HusseinElsherbini/Self_Balancing_Robot/Images/SBR_IMU_SCHEM.JPG

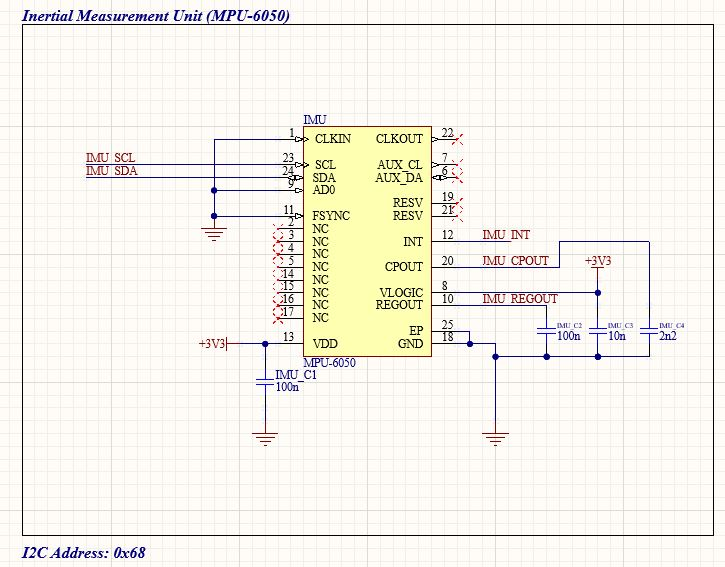
Images/SBR_IMU_SCHEM.JPG
