HusseinElsherbini/Self_Balancing_Robot/Images/SBR_MCU_SCHEM.JPG

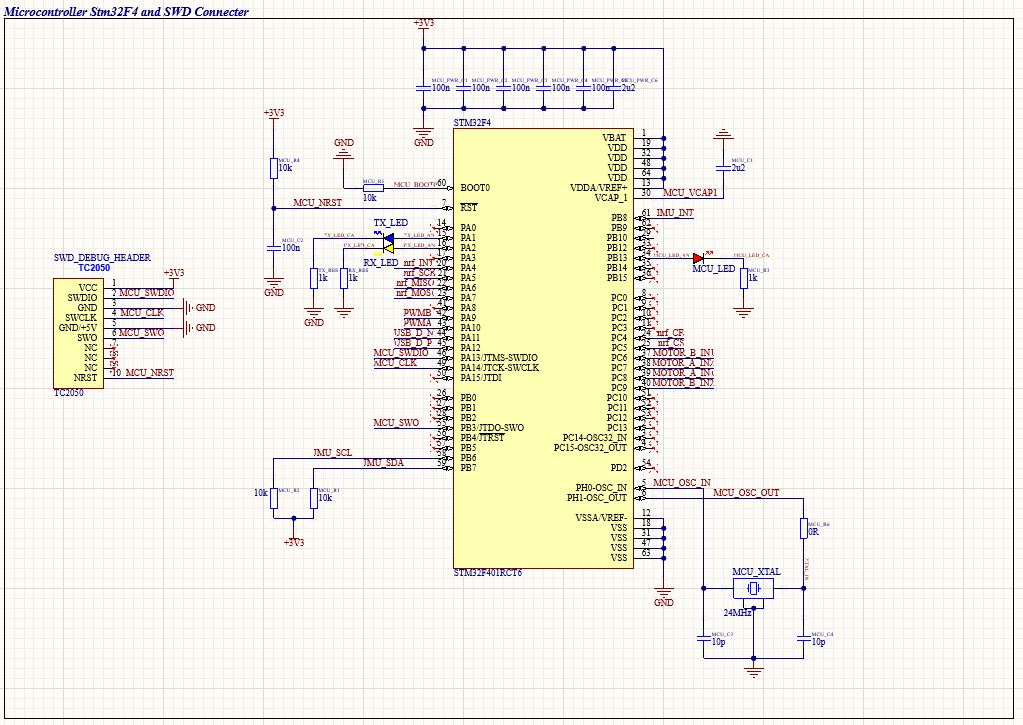
Images/SBR_MCU_SCHEM.JPG
