HusseinElsherbini/Self_Balancing_Robot/Images/SBR_SCHEM.JPG

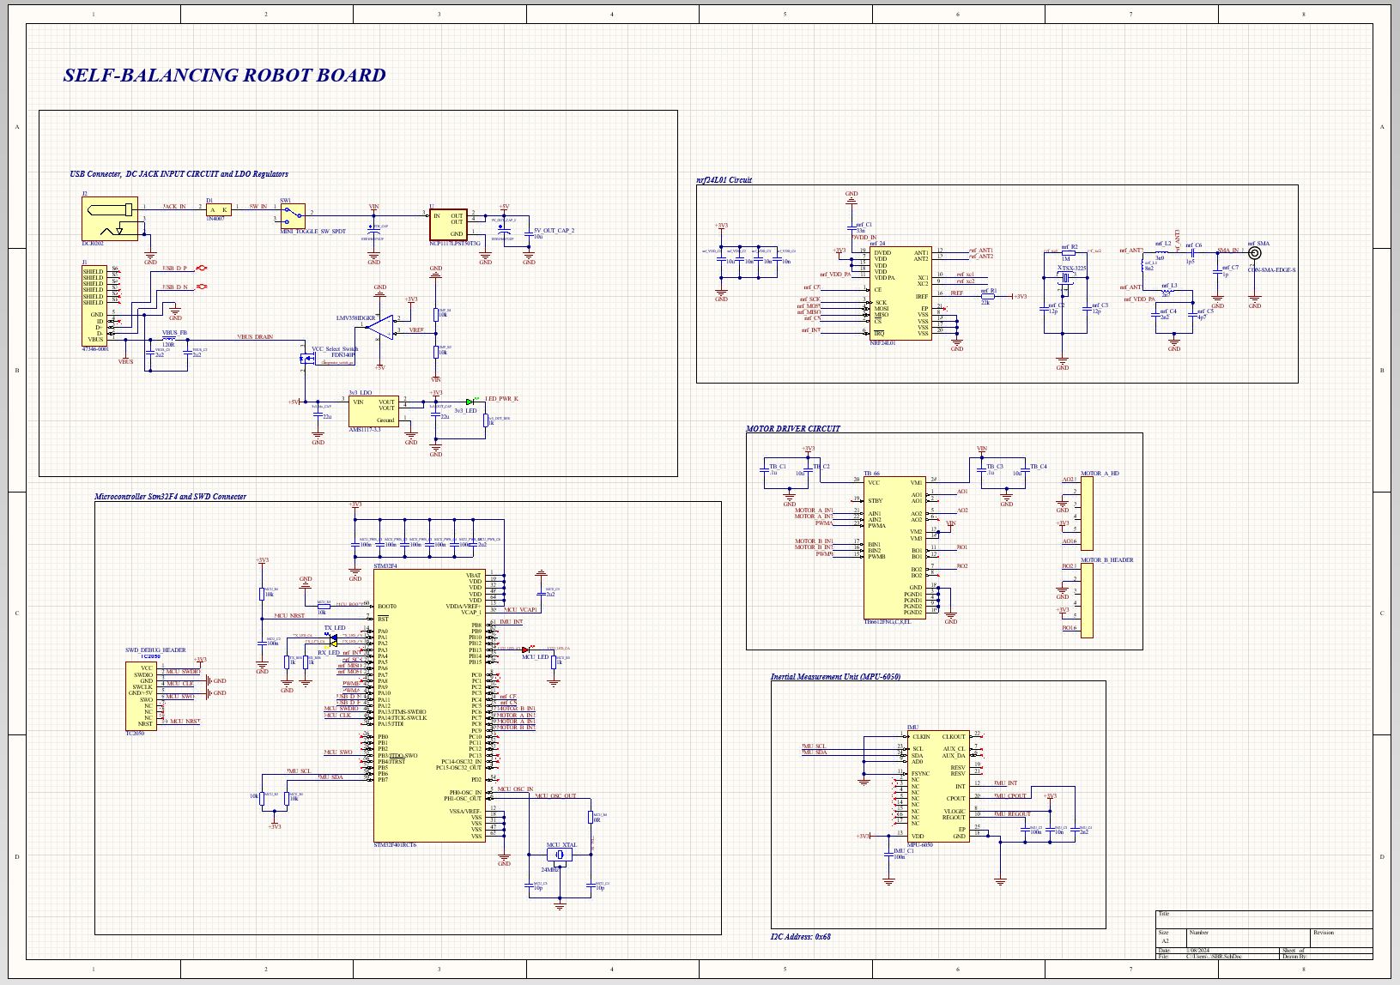
Images/SBR_SCHEM.JPG
