HusseinElsherbini/Self_Balancing_Robot/Images/SBR_TB66_SCHEM.JPG

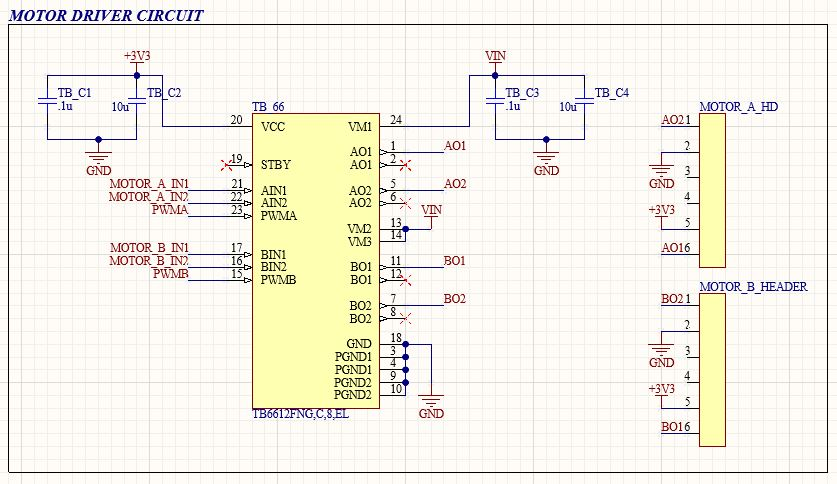
Images/SBR_TB66_SCHEM.JPG
