HusseinElsherbini/Self_Balancing_Robot/inc/timer_common.h

#ifndef TIMER_COMMON_H_
#define TIMER_COMMON_H_

#include "stdint.h"
#include "platform.h"

#define TIM_CR1_CKD_CK_INT      (0x0 << 8U)
#define TIM_CR1_CMS_EDGE        (0x0 << 5U)
#define TIM1_CR1_DIR_UP         (0x0 << 4U)
#define TIM1_CR1_DIR_DOWN       (0x1 << 4U)

#define RCC_APB1ENR_TIM2EN_Pos             (0U)                                
#define RCC_APB1ENR_TIM2EN_Msk             (0x1UL << RCC_APB1ENR_TIM2EN_Pos)    /*!< 0x00000001 */
#define RCC_APB1ENR_TIM2EN                 RCC_APB1ENR_TIM2EN_Msk          /*!< TIM2 clock enable */

#define RCC_APB1ENR_TIM3EN_Pos             (1U)
#define RCC_APB1ENR_TIM3EN_Msk             (0x1UL << RCC_APB1ENR_TIM3EN_Pos)    /*!< 0x00000002 */
#define RCC_APB1ENR_TIM3EN                 RCC_APB1ENR_TIM3EN_Msk          /*!< TIM3 clock enable */

#define RCC_APB1ENR_TIM4EN_Pos             (2U)
#define RCC_APB1ENR_TIM4EN_Msk             (0x1UL << RCC_APB1ENR_TIM4EN_Pos)    /*!< 0x00000004 */      
#define RCC_APB1ENR_TIM4EN                 RCC_APB1ENR_TIM4EN_Msk          /*!< TIM4 clock enable */

typedef struct 
{
    volatile uint32_t CR1;           
    volatile uint32_t CR2;       
    volatile uint32_t SMCR;       
    volatile uint32_t DIER;        
    volatile uint32_t SR;             
    volatile uint32_t EGR;            
    volatile uint32_t CCMR1;          
    volatile uint32_t CCMR2;            
    volatile uint32_t CCER;          
    volatile uint32_t CNT;     
    volatile uint32_t PSC;          
    volatile uint32_t ARR;     
    volatile uint32_t RCR;          
    volatile uint32_t CCR1;  
    volatile uint32_t CCR2;          
    volatile uint32_t CCR3; 
    volatile uint32_t CCR4;  
    volatile uint32_t BDTR;          
    volatile uint32_t DCR; 
    volatile uint32_t DMAR;  

}TIM_REGS_T;

#define TIM1                ((TIM_REGS_T *) TIM1_BASE)   
#define TIM2                ((TIM_REGS_T *) TIM2_BASE)
#define TIM3                ((TIM_REGS_T *) TIM3_BASE)
#define TIM4                ((TIM_REGS_T *) TIM4_BASE)
#define TIM5                ((TIM_REGS_T *) TIM5_BASE) 
#define TIM10               ((TIM_REGS_T *) TIM10_BASE)

#define CH1                1U
#define CH2                2U
#define CH3                3U
#define CH4                4U

#define CCRx_CHANNEL_PERIPH_OFFSET(CHANNEL)      (0x30 + 4U*CHANNEL)
#define TIMx_CCREG_CHANNEL_OFFSET_ADDRESS(TIMx_PERIPH_BASE, CHANNEL)     (TIMx_PERIPH_BASE + CCRx_CHANNEL_PERIPH_OFFSET(CHANNEL))

enum timer_oc_modes {

    FROZEN,
    ACTIVE,
    INACTIVE,
    TOGGLE,
    FORCE_LOW,
    FORCE_HIGH,
    PWM1,
    PWM2
};

enum timer_mode {

    OUTPUT_MODE,
    INPUT_MAPPED_TO_TI1,
    INPUT_MAPPED_TO_T12,
    INPUT_MAPPED_TO_TRC
};

typedef struct 
{
    TIM_REGS_T *timer_base_address;        /* timer port base address */
    uint32_t div_clk;
    uint8_t timxRccEn;
    uint32_t direction;
    uint8_t channel;
    uint8_t captureCompareSelect;
    uint32_t alignment;
    uint8_t timer_oc_mode;
    uint8_t timer_prescaler;

}TIMER_CONFIG_T;

typedef struct 
{
    TIMER_CONFIG_T timer_config;
    uint32_t autoreloadVal;
    uint32_t captureCompareVal;
    uint32_t *ccrReg;


}TIMER_TIM_T;

extern TIMER_TIM_T htim5;

// Timer Control Register 1 (CR1) bits
#define TIM_CR1_CEN      (1 << 0)    // Counter enable
#define TIM_CR1_DIR_MASK (1 << 4)    // Direction mask
#define TIM_CR1_CMS_MASK (3 << 5)    // Center-aligned mode mask
#define TIM_CR1_CKD_MASK (3 << 8)    // Clock division mask

// Timer DMA/Interrupt Enable Register (DIER) bits
#define TIM_DIER_UIE     (1 << 0)    // Update interrupt enable

// Timer Event Generation Register (EGR) bits
#define TIM_EGR_UG       (1 << 0)    // Update generation
#define TIM_CLEAR_FLAG(__HANDLE__, __FLAG__)        ((__HANDLE__)->Instance->SR = ~(__FLAG__))


#define TIM_SR_UIF_Pos            (0U)                                         
#define TIM_SR_UIF_Msk            (0x1UL << TIM_SR_UIF_Pos)                     /*!< 0x00000001 */
#define TIM_SR_UIF                TIM_SR_UIF_Msk    

/*******************  Bit definition for TIM_CR1 register  ********************/
#define TIM_CR1_CEN_Pos           (0U)                                         
#define TIM_CR1_CEN_Msk           (0x1UL << TIM_CR1_CEN_Pos)                    /*!< 0x00000001 */
#define TIM_CR1_CEN               TIM_CR1_CEN_Msk                              /*!<Counter enable        */
#define TIM_CR1_UDIS_Pos          (1U)                                         
#define TIM_CR1_UDIS_Msk          (0x1UL << TIM_CR1_UDIS_Pos)                   /*!< 0x00000002 */
#define TIM_CR1_UDIS              TIM_CR1_UDIS_Msk                             /*!<Update disable        */
#define TIM_CR1_URS_Pos           (2U)                                         
#define TIM_CR1_URS_Msk           (0x1UL << TIM_CR1_URS_Pos)                    /*!< 0x00000004 */
#define TIM_CR1_URS               TIM_CR1_URS_Msk                              /*!<Update request source */
#define TIM_CR1_OPM_Pos           (3U)                                         
#define TIM_CR1_OPM_Msk           (0x1UL << TIM_CR1_OPM_Pos)                    /*!< 0x00000008 */
#define TIM_CR1_OPM               TIM_CR1_OPM_Msk                              /*!<One pulse mode        */
#define TIM_CR1_DIR_Pos           (4U)                                         
#define TIM_CR1_DIR_Msk           (0x1UL << TIM_CR1_DIR_Pos)                    /*!< 0x00000010 */
#define TIM_CR1_DIR               TIM_CR1_DIR_Msk                              /*!<Direction             */

#define TIM_CR1_CMS_Pos           (5U)                                         
#define TIM_CR1_CMS_Msk           (0x3UL << TIM_CR1_CMS_Pos)                    /*!< 0x00000060 */
#define TIM_CR1_CMS               TIM_CR1_CMS_Msk                              /*!<CMS[1:0] bits (Center-aligned mode selection) */
#define TIM_CR1_CMS_0             (0x1UL << TIM_CR1_CMS_Pos)                    /*!< 0x0020 */
#define TIM_CR1_CMS_1             (0x2UL << TIM_CR1_CMS_Pos)                    /*!< 0x0040 */

#define TIM_CR1_ARPE_Pos          (7U)                                         
#define TIM_CR1_ARPE_Msk          (0x1UL << TIM_CR1_ARPE_Pos)                   /*!< 0x00000080 */
#define TIM_CR1_ARPE              TIM_CR1_ARPE_Msk                             /*!<Auto-reload preload enable     */

#define TIM_CR1_CKD_Pos           (8U)                                         
#define TIM_CR1_CKD_Msk           (0x3UL << TIM_CR1_CKD_Pos)                    /*!< 0x00000300 */
#define TIM_CR1_CKD               TIM_CR1_CKD_Msk                              /*!<CKD[1:0] bits (clock division) */
#define TIM_CR1_CKD_0             (0x1UL << TIM_CR1_CKD_Pos)                    /*!< 0x0100 */
#define TIM_CR1_CKD_1             (0x2UL << TIM_CR1_CKD_Pos)                    /*!< 0x0200 */

/*******************  Bit definition for TIM_CR2 register  ********************/
#define TIM_CR2_CCPC_Pos          (0U)                                         
#define TIM_CR2_CCPC_Msk          (0x1UL << TIM_CR2_CCPC_Pos)                   /*!< 0x00000001 */
#define TIM_CR2_CCPC              TIM_CR2_CCPC_Msk                             /*!<Capture/Compare Preloaded Control        */
#define TIM_CR2_CCUS_Pos          (2U)                                         
#define TIM_CR2_CCUS_Msk          (0x1UL << TIM_CR2_CCUS_Pos)                   /*!< 0x00000004 */
#define TIM_CR2_CCUS              TIM_CR2_CCUS_Msk                             /*!<Capture/Compare Control Update Selection */
#define TIM_CR2_CCDS_Pos          (3U)                                         
#define TIM_CR2_CCDS_Msk          (0x1UL << TIM_CR2_CCDS_Pos)                   /*!< 0x00000008 */
#define TIM_CR2_CCDS              TIM_CR2_CCDS_Msk                             /*!<Capture/Compare DMA Selection            */

#define TIM_CR2_MMS_Pos           (4U)                                         
#define TIM_CR2_MMS_Msk           (0x7UL << TIM_CR2_MMS_Pos)                    /*!< 0x00000070 */
#define TIM_CR2_MMS               TIM_CR2_MMS_Msk                              /*!<MMS[2:0] bits (Master Mode Selection) */
#define TIM_CR2_MMS_0             (0x1UL << TIM_CR2_MMS_Pos)                    /*!< 0x0010 */
#define TIM_CR2_MMS_1             (0x2UL << TIM_CR2_MMS_Pos)                    /*!< 0x0020 */
#define TIM_CR2_MMS_2             (0x4UL << TIM_CR2_MMS_Pos)                    /*!< 0x0040 */

#define TIM_CR2_TI1S_Pos          (7U)                                         
#define TIM_CR2_TI1S_Msk          (0x1UL << TIM_CR2_TI1S_Pos)                   /*!< 0x00000080 */
#define TIM_CR2_TI1S              TIM_CR2_TI1S_Msk                             /*!<TI1 Selection */
#define TIM_CR2_OIS1_Pos          (8U)                                         
#define TIM_CR2_OIS1_Msk          (0x1UL << TIM_CR2_OIS1_Pos)                   /*!< 0x00000100 */
#define TIM_CR2_OIS1              TIM_CR2_OIS1_Msk                             /*!<Output Idle state 1 (OC1 output)  */
#define TIM_CR2_OIS1N_Pos         (9U)                                         
#define TIM_CR2_OIS1N_Msk         (0x1UL << TIM_CR2_OIS1N_Pos)                  /*!< 0x00000200 */
#define TIM_CR2_OIS1N             TIM_CR2_OIS1N_Msk                            /*!<Output Idle state 1 (OC1N output) */
#define TIM_CR2_OIS2_Pos          (10U)                                        
#define TIM_CR2_OIS2_Msk          (0x1UL << TIM_CR2_OIS2_Pos)                   /*!< 0x00000400 */
#define TIM_CR2_OIS2              TIM_CR2_OIS2_Msk                             /*!<Output Idle state 2 (OC2 output)  */
#define TIM_CR2_OIS2N_Pos         (11U)                                        
#define TIM_CR2_OIS2N_Msk         (0x1UL << TIM_CR2_OIS2N_Pos)                  /*!< 0x00000800 */
#define TIM_CR2_OIS2N             TIM_CR2_OIS2N_Msk                            /*!<Output Idle state 2 (OC2N output) */
#define TIM_CR2_OIS3_Pos          (12U)                                        
#define TIM_CR2_OIS3_Msk          (0x1UL << TIM_CR2_OIS3_Pos)                   /*!< 0x00001000 */
#define TIM_CR2_OIS3              TIM_CR2_OIS3_Msk                             /*!<Output Idle state 3 (OC3 output)  */
#define TIM_CR2_OIS3N_Pos         (13U)                                        
#define TIM_CR2_OIS3N_Msk         (0x1UL << TIM_CR2_OIS3N_Pos)                  /*!< 0x00002000 */
#define TIM_CR2_OIS3N             TIM_CR2_OIS3N_Msk                            /*!<Output Idle state 3 (OC3N output) */
#define TIM_CR2_OIS4_Pos          (14U)                                        
#define TIM_CR2_OIS4_Msk          (0x1UL << TIM_CR2_OIS4_Pos)                   /*!< 0x00004000 */
#define TIM_CR2_OIS4              TIM_CR2_OIS4_Msk                             /*!<Output Idle state 4 (OC4 output)  */

/*******************  Bit definition for TIM_SMCR register  *******************/
#define TIM_SMCR_SMS_Pos          (0U)                                         
#define TIM_SMCR_SMS_Msk          (0x7UL << TIM_SMCR_SMS_Pos)                   /*!< 0x00000007 */
#define TIM_SMCR_SMS              TIM_SMCR_SMS_Msk                             /*!<SMS[2:0] bits (Slave mode selection)    */
#define TIM_SMCR_SMS_0            (0x1UL << TIM_SMCR_SMS_Pos)                   /*!< 0x0001 */
#define TIM_SMCR_SMS_1            (0x2UL << TIM_SMCR_SMS_Pos)                   /*!< 0x0002 */
#define TIM_SMCR_SMS_2            (0x4UL << TIM_SMCR_SMS_Pos)                   /*!< 0x0004 */

#define TIM_SMCR_TS_Pos           (4U)                                         
#define TIM_SMCR_TS_Msk           (0x7UL << TIM_SMCR_TS_Pos)                    /*!< 0x00000070 */
#define TIM_SMCR_TS               TIM_SMCR_TS_Msk                              /*!<TS[2:0] bits (Trigger selection)        */
#define TIM_SMCR_TS_0             (0x1UL << TIM_SMCR_TS_Pos)                    /*!< 0x0010 */
#define TIM_SMCR_TS_1             (0x2UL << TIM_SMCR_TS_Pos)                    /*!< 0x0020 */
#define TIM_SMCR_TS_2             (0x4UL << TIM_SMCR_TS_Pos)                    /*!< 0x0040 */

#define TIM_SMCR_MSM_Pos          (7U)                                         
#define TIM_SMCR_MSM_Msk          (0x1UL << TIM_SMCR_MSM_Pos)                   /*!< 0x00000080 */
#define TIM_SMCR_MSM              TIM_SMCR_MSM_Msk                             /*!<Master/slave mode                       */

#define TIM_SMCR_ETF_Pos          (8U)                                         
#define TIM_SMCR_ETF_Msk          (0xFUL << TIM_SMCR_ETF_Pos)                   /*!< 0x00000F00 */
#define TIM_SMCR_ETF              TIM_SMCR_ETF_Msk                             /*!<ETF[3:0] bits (External trigger filter) */
#define TIM_SMCR_ETF_0            (0x1UL << TIM_SMCR_ETF_Pos)                   /*!< 0x0100 */
#define TIM_SMCR_ETF_1            (0x2UL << TIM_SMCR_ETF_Pos)                   /*!< 0x0200 */
#define TIM_SMCR_ETF_2            (0x4UL << TIM_SMCR_ETF_Pos)                   /*!< 0x0400 */
#define TIM_SMCR_ETF_3            (0x8UL << TIM_SMCR_ETF_Pos)                   /*!< 0x0800 */

#define TIM_SMCR_ETPS_Pos         (12U)                                        
#define TIM_SMCR_ETPS_Msk         (0x3UL << TIM_SMCR_ETPS_Pos)                  /*!< 0x00003000 */
#define TIM_SMCR_ETPS             TIM_SMCR_ETPS_Msk                            /*!<ETPS[1:0] bits (External trigger prescaler) */
#define TIM_SMCR_ETPS_0           (0x1UL << TIM_SMCR_ETPS_Pos)                  /*!< 0x1000 */
#define TIM_SMCR_ETPS_1           (0x2UL << TIM_SMCR_ETPS_Pos)                  /*!< 0x2000 */

#define TIM_SMCR_ECE_Pos          (14U)                                        
#define TIM_SMCR_ECE_Msk          (0x1UL << TIM_SMCR_ECE_Pos)                   /*!< 0x00004000 */
#define TIM_SMCR_ECE              TIM_SMCR_ECE_Msk                             /*!<External clock enable     */
#define TIM_SMCR_ETP_Pos          (15U)                                        
#define TIM_SMCR_ETP_Msk          (0x1UL << TIM_SMCR_ETP_Pos)                   /*!< 0x00008000 */
#define TIM_SMCR_ETP              TIM_SMCR_ETP_Msk                             /*!<External trigger polarity */

/*******************  Bit definition for TIM_DIER register  *******************/
#define TIM_DIER_UIE_Pos          (0U)                                         
#define TIM_DIER_UIE_Msk          (0x1UL << TIM_DIER_UIE_Pos)                   /*!< 0x00000001 */
#define TIM_DIER_UIE              TIM_DIER_UIE_Msk                             /*!<Update interrupt enable */
#define TIM_DIER_CC1IE_Pos        (1U)                                         
#define TIM_DIER_CC1IE_Msk        (0x1UL << TIM_DIER_CC1IE_Pos)                 /*!< 0x00000002 */
#define TIM_DIER_CC1IE            TIM_DIER_CC1IE_Msk                           /*!<Capture/Compare 1 interrupt enable   */
#define TIM_DIER_CC2IE_Pos        (2U)                                         
#define TIM_DIER_CC2IE_Msk        (0x1UL << TIM_DIER_CC2IE_Pos)                 /*!< 0x00000004 */
#define TIM_DIER_CC2IE            TIM_DIER_CC2IE_Msk                           /*!<Capture/Compare 2 interrupt enable   */
#define TIM_DIER_CC3IE_Pos        (3U)                                         
#define TIM_DIER_CC3IE_Msk        (0x1UL << TIM_DIER_CC3IE_Pos)                 /*!< 0x00000008 */
#define TIM_DIER_CC3IE            TIM_DIER_CC3IE_Msk                           /*!<Capture/Compare 3 interrupt enable   */
#define TIM_DIER_CC4IE_Pos        (4U)                                         
#define TIM_DIER_CC4IE_Msk        (0x1UL << TIM_DIER_CC4IE_Pos)                 /*!< 0x00000010 */
#define TIM_DIER_CC4IE            TIM_DIER_CC4IE_Msk                           /*!<Capture/Compare 4 interrupt enable   */
#define TIM_DIER_COMIE_Pos        (5U)                                         
#define TIM_DIER_COMIE_Msk        (0x1UL << TIM_DIER_COMIE_Pos)                 /*!< 0x00000020 */
#define TIM_DIER_COMIE            TIM_DIER_COMIE_Msk                           /*!<COM interrupt enable                 */
#define TIM_DIER_TIE_Pos          (6U)                                         
#define TIM_DIER_TIE_Msk          (0x1UL << TIM_DIER_TIE_Pos)                   /*!< 0x00000040 */
#define TIM_DIER_TIE              TIM_DIER_TIE_Msk                             /*!<Trigger interrupt enable             */
#define TIM_DIER_BIE_Pos          (7U)                                         
#define TIM_DIER_BIE_Msk          (0x1UL << TIM_DIER_BIE_Pos)                   /*!< 0x00000080 */
#define TIM_DIER_BIE              TIM_DIER_BIE_Msk                             /*!<Break interrupt enable               */
#define TIM_DIER_UDE_Pos          (8U)                                         
#define TIM_DIER_UDE_Msk          (0x1UL << TIM_DIER_UDE_Pos)                   /*!< 0x00000100 */
#define TIM_DIER_UDE              TIM_DIER_UDE_Msk                             /*!<Update DMA request enable            */
#define TIM_DIER_CC1DE_Pos        (9U)                                         
#define TIM_DIER_CC1DE_Msk        (0x1UL << TIM_DIER_CC1DE_Pos)                 /*!< 0x00000200 */
#define TIM_DIER_CC1DE            TIM_DIER_CC1DE_Msk                           /*!<Capture/Compare 1 DMA request enable */
#define TIM_DIER_CC2DE_Pos        (10U)                                        
#define TIM_DIER_CC2DE_Msk        (0x1UL << TIM_DIER_CC2DE_Pos)                 /*!< 0x00000400 */
#define TIM_DIER_CC2DE            TIM_DIER_CC2DE_Msk                           /*!<Capture/Compare 2 DMA request enable */
#define TIM_DIER_CC3DE_Pos        (11U)                                        
#define TIM_DIER_CC3DE_Msk        (0x1UL << TIM_DIER_CC3DE_Pos)                 /*!< 0x00000800 */
#define TIM_DIER_CC3DE            TIM_DIER_CC3DE_Msk                           /*!<Capture/Compare 3 DMA request enable */
#define TIM_DIER_CC4DE_Pos        (12U)                                        
#define TIM_DIER_CC4DE_Msk        (0x1UL << TIM_DIER_CC4DE_Pos)                 /*!< 0x00001000 */
#define TIM_DIER_CC4DE            TIM_DIER_CC4DE_Msk                           /*!<Capture/Compare 4 DMA request enable */
#define TIM_DIER_COMDE_Pos        (13U)                                        
#define TIM_DIER_COMDE_Msk        (0x1UL << TIM_DIER_COMDE_Pos)                 /*!< 0x00002000 */
#define TIM_DIER_COMDE            TIM_DIER_COMDE_Msk                           /*!<COM DMA request enable               */
#define TIM_DIER_TDE_Pos          (14U)                                        
#define TIM_DIER_TDE_Msk          (0x1UL << TIM_DIER_TDE_Pos)                   /*!< 0x00004000 */
#define TIM_DIER_TDE              TIM_DIER_TDE_Msk                             /*!<Trigger DMA request enable           */

/********************  Bit definition for TIM_SR register  ********************/
#define TIM_SR_UIF_Pos            (0U)                                         
#define TIM_SR_UIF_Msk            (0x1UL << TIM_SR_UIF_Pos)                     /*!< 0x00000001 */
#define TIM_SR_UIF                TIM_SR_UIF_Msk                               /*!<Update interrupt Flag              */
#define TIM_SR_CC1IF_Pos          (1U)                                         
#define TIM_SR_CC1IF_Msk          (0x1UL << TIM_SR_CC1IF_Pos)                   /*!< 0x00000002 */
#define TIM_SR_CC1IF              TIM_SR_CC1IF_Msk                             /*!<Capture/Compare 1 interrupt Flag   */
#define TIM_SR_CC2IF_Pos          (2U)                                         
#define TIM_SR_CC2IF_Msk          (0x1UL << TIM_SR_CC2IF_Pos)                   /*!< 0x00000004 */
#define TIM_SR_CC2IF              TIM_SR_CC2IF_Msk                             /*!<Capture/Compare 2 interrupt Flag   */
#define TIM_SR_CC3IF_Pos          (3U)                                         
#define TIM_SR_CC3IF_Msk          (0x1UL << TIM_SR_CC3IF_Pos)                   /*!< 0x00000008 */
#define TIM_SR_CC3IF              TIM_SR_CC3IF_Msk                             /*!<Capture/Compare 3 interrupt Flag   */
#define TIM_SR_CC4IF_Pos          (4U)                                         
#define TIM_SR_CC4IF_Msk          (0x1UL << TIM_SR_CC4IF_Pos)                   /*!< 0x00000010 */
#define TIM_SR_CC4IF              TIM_SR_CC4IF_Msk                             /*!<Capture/Compare 4 interrupt Flag   */
#define TIM_SR_COMIF_Pos          (5U)                                         
#define TIM_SR_COMIF_Msk          (0x1UL << TIM_SR_COMIF_Pos)                   /*!< 0x00000020 */
#define TIM_SR_COMIF              TIM_SR_COMIF_Msk                             /*!<COM interrupt Flag                 */
#define TIM_SR_TIF_Pos            (6U)                                         
#define TIM_SR_TIF_Msk            (0x1UL << TIM_SR_TIF_Pos)                     /*!< 0x00000040 */
#define TIM_SR_TIF                TIM_SR_TIF_Msk                               /*!<Trigger interrupt Flag             */
#define TIM_SR_BIF_Pos            (7U)                                         
#define TIM_SR_BIF_Msk            (0x1UL << TIM_SR_BIF_Pos)                     /*!< 0x00000080 */
#define TIM_SR_BIF                TIM_SR_BIF_Msk                               /*!<Break interrupt Flag               */
#define TIM_SR_CC1OF_Pos          (9U)                                         
#define TIM_SR_CC1OF_Msk          (0x1UL << TIM_SR_CC1OF_Pos)                   /*!< 0x00000200 */
#define TIM_SR_CC1OF              TIM_SR_CC1OF_Msk                             /*!<Capture/Compare 1 Overcapture Flag */
#define TIM_SR_CC2OF_Pos          (10U)                                        
#define TIM_SR_CC2OF_Msk          (0x1UL << TIM_SR_CC2OF_Pos)                   /*!< 0x00000400 */
#define TIM_SR_CC2OF              TIM_SR_CC2OF_Msk                             /*!<Capture/Compare 2 Overcapture Flag */
#define TIM_SR_CC3OF_Pos          (11U)                                        
#define TIM_SR_CC3OF_Msk          (0x1UL << TIM_SR_CC3OF_Pos)                   /*!< 0x00000800 */
#define TIM_SR_CC3OF              TIM_SR_CC3OF_Msk                             /*!<Capture/Compare 3 Overcapture Flag */
#define TIM_SR_CC4OF_Pos          (12U)                                        
#define TIM_SR_CC4OF_Msk          (0x1UL << TIM_SR_CC4OF_Pos)                   /*!< 0x00001000 */
#define TIM_SR_CC4OF              TIM_SR_CC4OF_Msk                             /*!<Capture/Compare 4 Overcapture Flag */

/*******************  Bit definition for TIM_EGR register  ********************/
#define TIM_EGR_UG_Pos            (0U)                                         
#define TIM_EGR_UG_Msk            (0x1UL << TIM_EGR_UG_Pos)                     /*!< 0x00000001 */
#define TIM_EGR_UG                TIM_EGR_UG_Msk                               /*!<Update Generation                         */
#define TIM_EGR_CC1G_Pos          (1U)                                         
#define TIM_EGR_CC1G_Msk          (0x1UL << TIM_EGR_CC1G_Pos)                   /*!< 0x00000002 */
#define TIM_EGR_CC1G              TIM_EGR_CC1G_Msk                             /*!<Capture/Compare 1 Generation              */
#define TIM_EGR_CC2G_Pos          (2U)                                         
#define TIM_EGR_CC2G_Msk          (0x1UL << TIM_EGR_CC2G_Pos)                   /*!< 0x00000004 */
#define TIM_EGR_CC2G              TIM_EGR_CC2G_Msk                             /*!<Capture/Compare 2 Generation              */
#define TIM_EGR_CC3G_Pos          (3U)                                         
#define TIM_EGR_CC3G_Msk          (0x1UL << TIM_EGR_CC3G_Pos)                   /*!< 0x00000008 */
#define TIM_EGR_CC3G              TIM_EGR_CC3G_Msk                             /*!<Capture/Compare 3 Generation              */
#define TIM_EGR_CC4G_Pos          (4U)                                         
#define TIM_EGR_CC4G_Msk          (0x1UL << TIM_EGR_CC4G_Pos)                   /*!< 0x00000010 */
#define TIM_EGR_CC4G              TIM_EGR_CC4G_Msk                             /*!<Capture/Compare 4 Generation              */
#define TIM_EGR_COMG_Pos          (5U)                                         
#define TIM_EGR_COMG_Msk          (0x1UL << TIM_EGR_COMG_Pos)                   /*!< 0x00000020 */
#define TIM_EGR_COMG              TIM_EGR_COMG_Msk                             /*!<Capture/Compare Control Update Generation */
#define TIM_EGR_TG_Pos            (6U)                                         
#define TIM_EGR_TG_Msk            (0x1UL << TIM_EGR_TG_Pos)                     /*!< 0x00000040 */
#define TIM_EGR_TG                TIM_EGR_TG_Msk                               /*!<Trigger Generation                        */
#define TIM_EGR_BG_Pos            (7U)                                         
#define TIM_EGR_BG_Msk            (0x1UL << TIM_EGR_BG_Pos)                     /*!< 0x00000080 */
#define TIM_EGR_BG                TIM_EGR_BG_Msk                               /*!<Break Generation                          */

/******************  Bit definition for TIM_CCMR1 register  *******************/
#define TIM_CCMR1_CC1S_Pos        (0U)                                         
#define TIM_CCMR1_CC1S_Msk        (0x3UL << TIM_CCMR1_CC1S_Pos)                 /*!< 0x00000003 */
#define TIM_CCMR1_CC1S            TIM_CCMR1_CC1S_Msk                           /*!<CC1S[1:0] bits (Capture/Compare 1 Selection) */
#define TIM_CCMR1_CC1S_0          (0x1UL << TIM_CCMR1_CC1S_Pos)                 /*!< 0x0001 */
#define TIM_CCMR1_CC1S_1          (0x2UL << TIM_CCMR1_CC1S_Pos)                 /*!< 0x0002 */

#define TIM_CCMR1_OC1FE_Pos       (2U)                                         
#define TIM_CCMR1_OC1FE_Msk       (0x1UL << TIM_CCMR1_OC1FE_Pos)                /*!< 0x00000004 */
#define TIM_CCMR1_OC1FE           TIM_CCMR1_OC1FE_Msk                          /*!<Output Compare 1 Fast enable                 */
#define TIM_CCMR1_OC1PE_Pos       (3U)                                         
#define TIM_CCMR1_OC1PE_Msk       (0x1UL << TIM_CCMR1_OC1PE_Pos)                /*!< 0x00000008 */
#define TIM_CCMR1_OC1PE           TIM_CCMR1_OC1PE_Msk                          /*!<Output Compare 1 Preload enable              */

#define TIM_CCMR1_OC1M_Pos        (4U)                                         
#define TIM_CCMR1_OC1M_Msk        (0x7UL << TIM_CCMR1_OC1M_Pos)                 /*!< 0x00000070 */
#define TIM_CCMR1_OC1M            TIM_CCMR1_OC1M_Msk                           /*!<OC1M[2:0] bits (Output Compare 1 Mode)       */
#define TIM_CCMR1_OC1M_0          (0x1UL << TIM_CCMR1_OC1M_Pos)                 /*!< 0x0010 */
#define TIM_CCMR1_OC1M_1          (0x2UL << TIM_CCMR1_OC1M_Pos)                 /*!< 0x0020 */
#define TIM_CCMR1_OC1M_2          (0x4UL << TIM_CCMR1_OC1M_Pos)                 /*!< 0x0040 */

#define TIM_CCMR1_OC1CE_Pos       (7U)                                         
#define TIM_CCMR1_OC1CE_Msk       (0x1UL << TIM_CCMR1_OC1CE_Pos)                /*!< 0x00000080 */
#define TIM_CCMR1_OC1CE           TIM_CCMR1_OC1CE_Msk                          /*!<Output Compare 1Clear Enable                 */

#define TIM_CCMR1_CC2S_Pos        (8U)                                         
#define TIM_CCMR1_CC2S_Msk        (0x3UL << TIM_CCMR1_CC2S_Pos)                 /*!< 0x00000300 */
#define TIM_CCMR1_CC2S            TIM_CCMR1_CC2S_Msk                           /*!<CC2S[1:0] bits (Capture/Compare 2 Selection) */
#define TIM_CCMR1_CC2S_0          (0x1UL << TIM_CCMR1_CC2S_Pos)                 /*!< 0x0100 */
#define TIM_CCMR1_CC2S_1          (0x2UL << TIM_CCMR1_CC2S_Pos)                 /*!< 0x0200 */

#define TIM_CCMR1_OC2FE_Pos       (10U)                                        
#define TIM_CCMR1_OC2FE_Msk       (0x1UL << TIM_CCMR1_OC2FE_Pos)                /*!< 0x00000400 */
#define TIM_CCMR1_OC2FE           TIM_CCMR1_OC2FE_Msk                          /*!<Output Compare 2 Fast enable                 */
#define TIM_CCMR1_OC2PE_Pos       (11U)                                        
#define TIM_CCMR1_OC2PE_Msk       (0x1UL << TIM_CCMR1_OC2PE_Pos)                /*!< 0x00000800 */
#define TIM_CCMR1_OC2PE           TIM_CCMR1_OC2PE_Msk                          /*!<Output Compare 2 Preload enable              */

#define TIM_CCMR1_OC2M_Pos        (12U)                                        
#define TIM_CCMR1_OC2M_Msk        (0x7UL << TIM_CCMR1_OC2M_Pos)                 /*!< 0x00007000 */
#define TIM_CCMR1_OC2M            TIM_CCMR1_OC2M_Msk                           /*!<OC2M[2:0] bits (Output Compare 2 Mode)       */
#define TIM_CCMR1_OC2M_0          (0x1UL << TIM_CCMR1_OC2M_Pos)                 /*!< 0x1000 */
#define TIM_CCMR1_OC2M_1          (0x2UL << TIM_CCMR1_OC2M_Pos)                 /*!< 0x2000 */
#define TIM_CCMR1_OC2M_2          (0x4UL << TIM_CCMR1_OC2M_Pos)                 /*!< 0x4000 */

#define TIM_CCMR1_OC2CE_Pos       (15U)                                        
#define TIM_CCMR1_OC2CE_Msk       (0x1UL << TIM_CCMR1_OC2CE_Pos)                /*!< 0x00008000 */
#define TIM_CCMR1_OC2CE           TIM_CCMR1_OC2CE_Msk                          /*!<Output Compare 2 Clear Enable */

/*----------------------------------------------------------------------------*/

#define TIM_CCMR1_IC1PSC_Pos      (2U)                                         
#define TIM_CCMR1_IC1PSC_Msk      (0x3UL << TIM_CCMR1_IC1PSC_Pos)               /*!< 0x0000000C */
#define TIM_CCMR1_IC1PSC          TIM_CCMR1_IC1PSC_Msk                         /*!<IC1PSC[1:0] bits (Input Capture 1 Prescaler) */
#define TIM_CCMR1_IC1PSC_0        (0x1UL << TIM_CCMR1_IC1PSC_Pos)               /*!< 0x0004 */
#define TIM_CCMR1_IC1PSC_1        (0x2UL << TIM_CCMR1_IC1PSC_Pos)               /*!< 0x0008 */

#define TIM_CCMR1_IC1F_Pos        (4U)                                         
#define TIM_CCMR1_IC1F_Msk        (0xFUL << TIM_CCMR1_IC1F_Pos)                 /*!< 0x000000F0 */
#define TIM_CCMR1_IC1F            TIM_CCMR1_IC1F_Msk                           /*!<IC1F[3:0] bits (Input Capture 1 Filter)      */
#define TIM_CCMR1_IC1F_0          (0x1UL << TIM_CCMR1_IC1F_Pos)                 /*!< 0x0010 */
#define TIM_CCMR1_IC1F_1          (0x2UL << TIM_CCMR1_IC1F_Pos)                 /*!< 0x0020 */
#define TIM_CCMR1_IC1F_2          (0x4UL << TIM_CCMR1_IC1F_Pos)                 /*!< 0x0040 */
#define TIM_CCMR1_IC1F_3          (0x8UL << TIM_CCMR1_IC1F_Pos)                 /*!< 0x0080 */

#define TIM_CCMR1_IC2PSC_Pos      (10U)                                        
#define TIM_CCMR1_IC2PSC_Msk      (0x3UL << TIM_CCMR1_IC2PSC_Pos)               /*!< 0x00000C00 */
#define TIM_CCMR1_IC2PSC          TIM_CCMR1_IC2PSC_Msk                         /*!<IC2PSC[1:0] bits (Input Capture 2 Prescaler)  */
#define TIM_CCMR1_IC2PSC_0        (0x1UL << TIM_CCMR1_IC2PSC_Pos)               /*!< 0x0400 */
#define TIM_CCMR1_IC2PSC_1        (0x2UL << TIM_CCMR1_IC2PSC_Pos)               /*!< 0x0800 */

#define TIM_CCMR1_IC2F_Pos        (12U)                                        
#define TIM_CCMR1_IC2F_Msk        (0xFUL << TIM_CCMR1_IC2F_Pos)                 /*!< 0x0000F000 */
#define TIM_CCMR1_IC2F            TIM_CCMR1_IC2F_Msk                           /*!<IC2F[3:0] bits (Input Capture 2 Filter)       */
#define TIM_CCMR1_IC2F_0          (0x1UL << TIM_CCMR1_IC2F_Pos)                 /*!< 0x1000 */
#define TIM_CCMR1_IC2F_1          (0x2UL << TIM_CCMR1_IC2F_Pos)                 /*!< 0x2000 */
#define TIM_CCMR1_IC2F_2          (0x4UL << TIM_CCMR1_IC2F_Pos)                 /*!< 0x4000 */
#define TIM_CCMR1_IC2F_3          (0x8UL << TIM_CCMR1_IC2F_Pos)                 /*!< 0x8000 */

/******************  Bit definition for TIM_CCMR2 register  *******************/
#define TIM_CCMR2_CC3S_Pos        (0U)                                         
#define TIM_CCMR2_CC3S_Msk        (0x3UL << TIM_CCMR2_CC3S_Pos)                 /*!< 0x00000003 */
#define TIM_CCMR2_CC3S            TIM_CCMR2_CC3S_Msk                           /*!<CC3S[1:0] bits (Capture/Compare 3 Selection)  */
#define TIM_CCMR2_CC3S_0          (0x1UL << TIM_CCMR2_CC3S_Pos)                 /*!< 0x0001 */
#define TIM_CCMR2_CC3S_1          (0x2UL << TIM_CCMR2_CC3S_Pos)                 /*!< 0x0002 */

#define TIM_CCMR2_OC3FE_Pos       (2U)                                         
#define TIM_CCMR2_OC3FE_Msk       (0x1UL << TIM_CCMR2_OC3FE_Pos)                /*!< 0x00000004 */
#define TIM_CCMR2_OC3FE           TIM_CCMR2_OC3FE_Msk                          /*!<Output Compare 3 Fast enable           */
#define TIM_CCMR2_OC3PE_Pos       (3U)                                         
#define TIM_CCMR2_OC3PE_Msk       (0x1UL << TIM_CCMR2_OC3PE_Pos)                /*!< 0x00000008 */
#define TIM_CCMR2_OC3PE           TIM_CCMR2_OC3PE_Msk                          /*!<Output Compare 3 Preload enable        */

#define TIM_CCMR2_OC3M_Pos        (4U)                                         
#define TIM_CCMR2_OC3M_Msk        (0x7UL << TIM_CCMR2_OC3M_Pos)                 /*!< 0x00000070 */
#define TIM_CCMR2_OC3M            TIM_CCMR2_OC3M_Msk                           /*!<OC3M[2:0] bits (Output Compare 3 Mode) */
#define TIM_CCMR2_OC3M_0          (0x1UL << TIM_CCMR2_OC3M_Pos)                 /*!< 0x0010 */
#define TIM_CCMR2_OC3M_1          (0x2UL << TIM_CCMR2_OC3M_Pos)                 /*!< 0x0020 */
#define TIM_CCMR2_OC3M_2          (0x4UL << TIM_CCMR2_OC3M_Pos)                 /*!< 0x0040 */

#define TIM_CCMR2_OC3CE_Pos       (7U)                                         
#define TIM_CCMR2_OC3CE_Msk       (0x1UL << TIM_CCMR2_OC3CE_Pos)                /*!< 0x00000080 */
#define TIM_CCMR2_OC3CE           TIM_CCMR2_OC3CE_Msk                          /*!<Output Compare 3 Clear Enable */

#define TIM_CCMR2_CC4S_Pos        (8U)                                         
#define TIM_CCMR2_CC4S_Msk        (0x3UL << TIM_CCMR2_CC4S_Pos)                 /*!< 0x00000300 */
#define TIM_CCMR2_CC4S            TIM_CCMR2_CC4S_Msk                           /*!<CC4S[1:0] bits (Capture/Compare 4 Selection) */
#define TIM_CCMR2_CC4S_0          (0x1UL << TIM_CCMR2_CC4S_Pos)                 /*!< 0x0100 */
#define TIM_CCMR2_CC4S_1          (0x2UL << TIM_CCMR2_CC4S_Pos)                 /*!< 0x0200 */

#define TIM_CCMR2_OC4FE_Pos       (10U)                                        
#define TIM_CCMR2_OC4FE_Msk       (0x1UL << TIM_CCMR2_OC4FE_Pos)                /*!< 0x00000400 */
#define TIM_CCMR2_OC4FE           TIM_CCMR2_OC4FE_Msk                          /*!<Output Compare 4 Fast enable    */
#define TIM_CCMR2_OC4PE_Pos       (11U)                                        
#define TIM_CCMR2_OC4PE_Msk       (0x1UL << TIM_CCMR2_OC4PE_Pos)                /*!< 0x00000800 */
#define TIM_CCMR2_OC4PE           TIM_CCMR2_OC4PE_Msk                          /*!<Output Compare 4 Preload enable */

#define TIM_CCMR2_OC4M_Pos        (12U)                                        
#define TIM_CCMR2_OC4M_Msk        (0x7UL << TIM_CCMR2_OC4M_Pos)                 /*!< 0x00007000 */
#define TIM_CCMR2_OC4M            TIM_CCMR2_OC4M_Msk                           /*!<OC4M[2:0] bits (Output Compare 4 Mode) */
#define TIM_CCMR2_OC4M_0          (0x1UL << TIM_CCMR2_OC4M_Pos)                 /*!< 0x1000 */
#define TIM_CCMR2_OC4M_1          (0x2UL << TIM_CCMR2_OC4M_Pos)                 /*!< 0x2000 */
#define TIM_CCMR2_OC4M_2          (0x4UL << TIM_CCMR2_OC4M_Pos)                 /*!< 0x4000 */

#define TIM_CCMR2_OC4CE_Pos       (15U)                                        
#define TIM_CCMR2_OC4CE_Msk       (0x1UL << TIM_CCMR2_OC4CE_Pos)                /*!< 0x00008000 */
#define TIM_CCMR2_OC4CE           TIM_CCMR2_OC4CE_Msk                          /*!<Output Compare 4 Clear Enable */

/*----------------------------------------------------------------------------*/

#define TIM_CCMR2_IC3PSC_Pos      (2U)                                         
#define TIM_CCMR2_IC3PSC_Msk      (0x3UL << TIM_CCMR2_IC3PSC_Pos)               /*!< 0x0000000C */
#define TIM_CCMR2_IC3PSC          TIM_CCMR2_IC3PSC_Msk                         /*!<IC3PSC[1:0] bits (Input Capture 3 Prescaler) */
#define TIM_CCMR2_IC3PSC_0        (0x1UL << TIM_CCMR2_IC3PSC_Pos)               /*!< 0x0004 */
#define TIM_CCMR2_IC3PSC_1        (0x2UL << TIM_CCMR2_IC3PSC_Pos)               /*!< 0x0008 */

#define TIM_CCMR2_IC3F_Pos        (4U)                                         
#define TIM_CCMR2_IC3F_Msk        (0xFUL << TIM_CCMR2_IC3F_Pos)                 /*!< 0x000000F0 */
#define TIM_CCMR2_IC3F            TIM_CCMR2_IC3F_Msk                           /*!<IC3F[3:0] bits (Input Capture 3 Filter) */
#define TIM_CCMR2_IC3F_0          (0x1UL << TIM_CCMR2_IC3F_Pos)                 /*!< 0x0010 */
#define TIM_CCMR2_IC3F_1          (0x2UL << TIM_CCMR2_IC3F_Pos)                 /*!< 0x0020 */
#define TIM_CCMR2_IC3F_2          (0x4UL << TIM_CCMR2_IC3F_Pos)                 /*!< 0x0040 */
#define TIM_CCMR2_IC3F_3          (0x8UL << TIM_CCMR2_IC3F_Pos)                 /*!< 0x0080 */

#define TIM_CCMR2_IC4PSC_Pos      (10U)                                        
#define TIM_CCMR2_IC4PSC_Msk      (0x3UL << TIM_CCMR2_IC4PSC_Pos)               /*!< 0x00000C00 */
#define TIM_CCMR2_IC4PSC          TIM_CCMR2_IC4PSC_Msk                         /*!<IC4PSC[1:0] bits (Input Capture 4 Prescaler) */
#define TIM_CCMR2_IC4PSC_0        (0x1UL << TIM_CCMR2_IC4PSC_Pos)               /*!< 0x0400 */
#define TIM_CCMR2_IC4PSC_1        (0x2UL << TIM_CCMR2_IC4PSC_Pos)               /*!< 0x0800 */

#define TIM_CCMR2_IC4F_Pos        (12U)                                        
#define TIM_CCMR2_IC4F_Msk        (0xFUL << TIM_CCMR2_IC4F_Pos)                 /*!< 0x0000F000 */
#define TIM_CCMR2_IC4F            TIM_CCMR2_IC4F_Msk                           /*!<IC4F[3:0] bits (Input Capture 4 Filter) */
#define TIM_CCMR2_IC4F_0          (0x1UL << TIM_CCMR2_IC4F_Pos)                 /*!< 0x1000 */
#define TIM_CCMR2_IC4F_1          (0x2UL << TIM_CCMR2_IC4F_Pos)                 /*!< 0x2000 */
#define TIM_CCMR2_IC4F_2          (0x4UL << TIM_CCMR2_IC4F_Pos)                 /*!< 0x4000 */
#define TIM_CCMR2_IC4F_3          (0x8UL << TIM_CCMR2_IC4F_Pos)                 /*!< 0x8000 */

/*******************  Bit definition for TIM_CCER register  *******************/
#define TIM_CCER_CC1E_Pos         (0U)                                         
#define TIM_CCER_CC1E_Msk         (0x1UL << TIM_CCER_CC1E_Pos)                  /*!< 0x00000001 */
#define TIM_CCER_CC1E             TIM_CCER_CC1E_Msk                            /*!<Capture/Compare 1 output enable                 */
#define TIM_CCER_CC1P_Pos         (1U)                                         
#define TIM_CCER_CC1P_Msk         (0x1UL << TIM_CCER_CC1P_Pos)                  /*!< 0x00000002 */
#define TIM_CCER_CC1P             TIM_CCER_CC1P_Msk                            /*!<Capture/Compare 1 output Polarity               */
#define TIM_CCER_CC1NE_Pos        (2U)                                         
#define TIM_CCER_CC1NE_Msk        (0x1UL << TIM_CCER_CC1NE_Pos)                 /*!< 0x00000004 */
#define TIM_CCER_CC1NE            TIM_CCER_CC1NE_Msk                           /*!<Capture/Compare 1 Complementary output enable   */
#define TIM_CCER_CC1NP_Pos        (3U)                                         
#define TIM_CCER_CC1NP_Msk        (0x1UL << TIM_CCER_CC1NP_Pos)                 /*!< 0x00000008 */
#define TIM_CCER_CC1NP            TIM_CCER_CC1NP_Msk                           /*!<Capture/Compare 1 Complementary output Polarity */
#define TIM_CCER_CC2E_Pos         (4U)                                         
#define TIM_CCER_CC2E_Msk         (0x1UL << TIM_CCER_CC2E_Pos)                  /*!< 0x00000010 */
#define TIM_CCER_CC2E             TIM_CCER_CC2E_Msk                            /*!<Capture/Compare 2 output enable                 */
#define TIM_CCER_CC2P_Pos         (5U)                                         
#define TIM_CCER_CC2P_Msk         (0x1UL << TIM_CCER_CC2P_Pos)                  /*!< 0x00000020 */
#define TIM_CCER_CC2P             TIM_CCER_CC2P_Msk                            /*!<Capture/Compare 2 output Polarity               */
#define TIM_CCER_CC2NE_Pos        (6U)                                         
#define TIM_CCER_CC2NE_Msk        (0x1UL << TIM_CCER_CC2NE_Pos)                 /*!< 0x00000040 */
#define TIM_CCER_CC2NE            TIM_CCER_CC2NE_Msk                           /*!<Capture/Compare 2 Complementary output enable   */
#define TIM_CCER_CC2NP_Pos        (7U)                                         
#define TIM_CCER_CC2NP_Msk        (0x1UL << TIM_CCER_CC2NP_Pos)                 /*!< 0x00000080 */
#define TIM_CCER_CC2NP            TIM_CCER_CC2NP_Msk                           /*!<Capture/Compare 2 Complementary output Polarity */
#define TIM_CCER_CC3E_Pos         (8U)                                         
#define TIM_CCER_CC3E_Msk         (0x1UL << TIM_CCER_CC3E_Pos)                  /*!< 0x00000100 */
#define TIM_CCER_CC3E             TIM_CCER_CC3E_Msk                            /*!<Capture/Compare 3 output enable                 */
#define TIM_CCER_CC3P_Pos         (9U)                                         
#define TIM_CCER_CC3P_Msk         (0x1UL << TIM_CCER_CC3P_Pos)                  /*!< 0x00000200 */
#define TIM_CCER_CC3P             TIM_CCER_CC3P_Msk                            /*!<Capture/Compare 3 output Polarity               */
#define TIM_CCER_CC3NE_Pos        (10U)                                        
#define TIM_CCER_CC3NE_Msk        (0x1UL << TIM_CCER_CC3NE_Pos)                 /*!< 0x00000400 */
#define TIM_CCER_CC3NE            TIM_CCER_CC3NE_Msk                           /*!<Capture/Compare 3 Complementary output enable   */
#define TIM_CCER_CC3NP_Pos        (11U)                                        
#define TIM_CCER_CC3NP_Msk        (0x1UL << TIM_CCER_CC3NP_Pos)                 /*!< 0x00000800 */
#define TIM_CCER_CC3NP            TIM_CCER_CC3NP_Msk                           /*!<Capture/Compare 3 Complementary output Polarity */
#define TIM_CCER_CC4E_Pos         (12U)                                        
#define TIM_CCER_CC4E_Msk         (0x1UL << TIM_CCER_CC4E_Pos)                  /*!< 0x00001000 */
#define TIM_CCER_CC4E             TIM_CCER_CC4E_Msk                            /*!<Capture/Compare 4 output enable                 */
#define TIM_CCER_CC4P_Pos         (13U)                                        
#define TIM_CCER_CC4P_Msk         (0x1UL << TIM_CCER_CC4P_Pos)                  /*!< 0x00002000 */
#define TIM_CCER_CC4P             TIM_CCER_CC4P_Msk                            /*!<Capture/Compare 4 output Polarity               */
#define TIM_CCER_CC4NP_Pos        (15U)                                        
#define TIM_CCER_CC4NP_Msk        (0x1UL << TIM_CCER_CC4NP_Pos)                 /*!< 0x00008000 */
#define TIM_CCER_CC4NP            TIM_CCER_CC4NP_Msk                           /*!<Capture/Compare 4 Complementary output Polarity */

/*******************  Bit definition for TIM_CNT register  ********************/
#define TIM_CNT_CNT_Pos           (0U)                                             
#define TIM_CNT_CNT_Msk           (0xFFFFFFFFUL << TIM_CNT_CNT_Pos)                 /*!< 0xFFFFFFFF */
#define TIM_CNT_CNT               TIM_CNT_CNT_Msk                                  /*!<Counter Value            */

/*******************  Bit definition for TIM_PSC register  ********************/
#define TIM_PSC_PSC_Pos           (0U)                                         
#define TIM_PSC_PSC_Msk           (0xFFFFUL << TIM_PSC_PSC_Pos)                 /*!< 0x0000FFFF */
#define TIM_PSC_PSC               TIM_PSC_PSC_Msk                              /*!<Prescaler Value          */

/*******************  Bit definition for TIM_ARR register  ********************/
#define TIM_ARR_ARR_Pos           (0U)                                         
#define TIM_ARR_ARR_Msk           (0xFFFFFFFFUL << TIM_ARR_ARR_Pos)             /*!< 0xFFFFFFFF */
#define TIM_ARR_ARR               TIM_ARR_ARR_Msk                              /*!<actual auto-reload Value */

/*******************  Bit definition for TIM_RCR register  ********************/
#define TIM_RCR_REP_Pos           (0U)                                         
#define TIM_RCR_REP_Msk           (0xFFUL << TIM_RCR_REP_Pos)                   /*!< 0x000000FF */
#define TIM_RCR_REP               TIM_RCR_REP_Msk                              /*!<Repetition Counter Value */

/*******************  Bit definition for TIM_CCR1 register  *******************/
#define TIM_CCR1_CCR1_Pos         (0U)                                         
#define TIM_CCR1_CCR1_Msk         (0xFFFFUL << TIM_CCR1_CCR1_Pos)               /*!< 0x0000FFFF */
#define TIM_CCR1_CCR1             TIM_CCR1_CCR1_Msk                            /*!<Capture/Compare 1 Value  */

/*******************  Bit definition for TIM_CCR2 register  *******************/
#define TIM_CCR2_CCR2_Pos         (0U)                                         
#define TIM_CCR2_CCR2_Msk         (0xFFFFUL << TIM_CCR2_CCR2_Pos)               /*!< 0x0000FFFF */
#define TIM_CCR2_CCR2             TIM_CCR2_CCR2_Msk                            /*!<Capture/Compare 2 Value  */

/*******************  Bit definition for TIM_CCR3 register  *******************/
#define TIM_CCR3_CCR3_Pos         (0U)                                         
#define TIM_CCR3_CCR3_Msk         (0xFFFFUL << TIM_CCR3_CCR3_Pos)               /*!< 0x0000FFFF */
#define TIM_CCR3_CCR3             TIM_CCR3_CCR3_Msk                            /*!<Capture/Compare 3 Value  */

/*******************  Bit definition for TIM_CCR4 register  *******************/
#define TIM_CCR4_CCR4_Pos         (0U)                                         
#define TIM_CCR4_CCR4_Msk         (0xFFFFUL << TIM_CCR4_CCR4_Pos)               /*!< 0x0000FFFF */
#define TIM_CCR4_CCR4             TIM_CCR4_CCR4_Msk                            /*!<Capture/Compare 4 Value  */

/*******************  Bit definition for TIM_BDTR register  *******************/
#define TIM_BDTR_DTG_Pos          (0U)                                         
#define TIM_BDTR_DTG_Msk          (0xFFUL << TIM_BDTR_DTG_Pos)                  /*!< 0x000000FF */
#define TIM_BDTR_DTG              TIM_BDTR_DTG_Msk                             /*!<DTG[0:7] bits (Dead-Time Generator set-up) */
#define TIM_BDTR_DTG_0            (0x01UL << TIM_BDTR_DTG_Pos)                  /*!< 0x0001 */
#define TIM_BDTR_DTG_1            (0x02UL << TIM_BDTR_DTG_Pos)                  /*!< 0x0002 */
#define TIM_BDTR_DTG_2            (0x04UL << TIM_BDTR_DTG_Pos)                  /*!< 0x0004 */
#define TIM_BDTR_DTG_3            (0x08UL << TIM_BDTR_DTG_Pos)                  /*!< 0x0008 */
#define TIM_BDTR_DTG_4            (0x10UL << TIM_BDTR_DTG_Pos)                  /*!< 0x0010 */
#define TIM_BDTR_DTG_5            (0x20UL << TIM_BDTR_DTG_Pos)                  /*!< 0x0020 */
#define TIM_BDTR_DTG_6            (0x40UL << TIM_BDTR_DTG_Pos)                  /*!< 0x0040 */
#define TIM_BDTR_DTG_7            (0x80UL << TIM_BDTR_DTG_Pos)                  /*!< 0x0080 */

#define TIM_BDTR_LOCK_Pos         (8U)                                         
#define TIM_BDTR_LOCK_Msk         (0x3UL << TIM_BDTR_LOCK_Pos)                  /*!< 0x00000300 */
#define TIM_BDTR_LOCK             TIM_BDTR_LOCK_Msk                            /*!<LOCK[1:0] bits (Lock Configuration) */
#define TIM_BDTR_LOCK_0           (0x1UL << TIM_BDTR_LOCK_Pos)                  /*!< 0x0100 */
#define TIM_BDTR_LOCK_1           (0x2UL << TIM_BDTR_LOCK_Pos)                  /*!< 0x0200 */

#define TIM_BDTR_OSSI_Pos         (10U)                                        
#define TIM_BDTR_OSSI_Msk         (0x1UL << TIM_BDTR_OSSI_Pos)                  /*!< 0x00000400 */
#define TIM_BDTR_OSSI             TIM_BDTR_OSSI_Msk                            /*!<Off-State Selection for Idle mode */
#define TIM_BDTR_OSSR_Pos         (11U)                                        
#define TIM_BDTR_OSSR_Msk         (0x1UL << TIM_BDTR_OSSR_Pos)                  /*!< 0x00000800 */
#define TIM_BDTR_OSSR             TIM_BDTR_OSSR_Msk                            /*!<Off-State Selection for Run mode  */
#define TIM_BDTR_BKE_Pos          (12U)                                        
#define TIM_BDTR_BKE_Msk          (0x1UL << TIM_BDTR_BKE_Pos)                   /*!< 0x00001000 */
#define TIM_BDTR_BKE              TIM_BDTR_BKE_Msk                             /*!<Break enable                      */
#define TIM_BDTR_BKP_Pos          (13U)                                        
#define TIM_BDTR_BKP_Msk          (0x1UL << TIM_BDTR_BKP_Pos)                   /*!< 0x00002000 */
#define TIM_BDTR_BKP              TIM_BDTR_BKP_Msk                             /*!<Break Polarity                    */
#define TIM_BDTR_AOE_Pos          (14U)                                        
#define TIM_BDTR_AOE_Msk          (0x1UL << TIM_BDTR_AOE_Pos)                   /*!< 0x00004000 */
#define TIM_BDTR_AOE              TIM_BDTR_AOE_Msk                             /*!<Automatic Output enable           */
#define TIM_BDTR_MOE_Pos          (15U)                                        
#define TIM_BDTR_MOE_Msk          (0x1UL << TIM_BDTR_MOE_Pos)                   /*!< 0x00008000 */
#define TIM_BDTR_MOE              TIM_BDTR_MOE_Msk                             /*!<Main Output enable                */

/*******************  Bit definition for TIM_DCR register  ********************/
#define TIM_DCR_DBA_Pos           (0U)                                         
#define TIM_DCR_DBA_Msk           (0x1FUL << TIM_DCR_DBA_Pos)                   /*!< 0x0000001F */
#define TIM_DCR_DBA               TIM_DCR_DBA_Msk                              /*!<DBA[4:0] bits (DMA Base Address) */
#define TIM_DCR_DBA_0             (0x01UL << TIM_DCR_DBA_Pos)                   /*!< 0x0001 */
#define TIM_DCR_DBA_1             (0x02UL << TIM_DCR_DBA_Pos)                   /*!< 0x0002 */
#define TIM_DCR_DBA_2             (0x04UL << TIM_DCR_DBA_Pos)                   /*!< 0x0004 */
#define TIM_DCR_DBA_3             (0x08UL << TIM_DCR_DBA_Pos)                   /*!< 0x0008 */
#define TIM_DCR_DBA_4             (0x10UL << TIM_DCR_DBA_Pos)                   /*!< 0x0010 */

#define TIM_DCR_DBL_Pos           (8U)                                         
#define TIM_DCR_DBL_Msk           (0x1FUL << TIM_DCR_DBL_Pos)                   /*!< 0x00001F00 */
#define TIM_DCR_DBL               TIM_DCR_DBL_Msk                              /*!<DBL[4:0] bits (DMA Burst Length) */
#define TIM_DCR_DBL_0             (0x01UL << TIM_DCR_DBL_Pos)                   /*!< 0x0100 */
#define TIM_DCR_DBL_1             (0x02UL << TIM_DCR_DBL_Pos)                   /*!< 0x0200 */
#define TIM_DCR_DBL_2             (0x04UL << TIM_DCR_DBL_Pos)                   /*!< 0x0400 */
#define TIM_DCR_DBL_3             (0x08UL << TIM_DCR_DBL_Pos)                   /*!< 0x0800 */
#define TIM_DCR_DBL_4             (0x10UL << TIM_DCR_DBL_Pos)                   /*!< 0x1000 */

/*******************  Bit definition for TIM_DMAR register  *******************/
#define TIM_DMAR_DMAB_Pos         (0U)                                         
#define TIM_DMAR_DMAB_Msk         (0xFFFFUL << TIM_DMAR_DMAB_Pos)               /*!< 0x0000FFFF */
#define TIM_DMAR_DMAB             TIM_DMAR_DMAB_Msk                            /*!<DMA register for burst accesses                    */

/*******************  Bit definition for TIM_OR register  *********************/
#define TIM_OR_TI1_RMP_Pos        (0U)                                          
#define TIM_OR_TI1_RMP_Msk        (0x3UL << TIM_OR_TI1_RMP_Pos)                 /*!< 0x00000003 */
#define TIM_OR_TI1_RMP            TIM_OR_TI1_RMP_Msk                           /*!< TI1_RMP[1:0] bits (TIM11 Input Capture 1 remap) */
#define TIM_OR_TI1_RMP_0          (0x1UL << TIM_OR_TI1_RMP_Pos)                 /*!< 0x00000001 */
#define TIM_OR_TI1_RMP_1          (0x2UL << TIM_OR_TI1_RMP_Pos)                 /*!< 0x00000002 */

#define TIM_OR_TI4_RMP_Pos        (6U)                                         
#define TIM_OR_TI4_RMP_Msk        (0x3UL << TIM_OR_TI4_RMP_Pos)                 /*!< 0x000000C0 */
#define TIM_OR_TI4_RMP            TIM_OR_TI4_RMP_Msk                           /*!<TI4_RMP[1:0] bits (TIM5 Input 4 remap)             */
#define TIM_OR_TI4_RMP_0          (0x1UL << TIM_OR_TI4_RMP_Pos)                 /*!< 0x0040 */
#define TIM_OR_TI4_RMP_1          (0x2UL << TIM_OR_TI4_RMP_Pos)                 /*!< 0x0080 */
#define TIM_OR_ITR1_RMP_Pos       (10U)                                        
#define TIM_OR_ITR1_RMP_Msk       (0x3UL << TIM_OR_ITR1_RMP_Pos)                /*!< 0x00000C00 */
#define TIM_OR_ITR1_RMP           TIM_OR_ITR1_RMP_Msk                          /*!<ITR1_RMP[1:0] bits (TIM2 Internal trigger 1 remap) */
#define TIM_OR_ITR1_RMP_0         (0x1UL << TIM_OR_ITR1_RMP_Pos)                /*!< 0x0400 */
#define TIM_OR_ITR1_RMP_1         (0x2UL << TIM_OR_ITR1_RMP_Pos)                /*!< 0x0800 */

void setup_timer_mode(TIMER_CONFIG_T * timerConfig);
void setup_timer_freq(TIMER_CONFIG_T *timerConfig, uint16_t arr_val);
void setup_timer_oc_mode(TIMER_CONFIG_T * timerConfig);
void timer_setup(TIMER_TIM_T * timer);
void enableBustToTimerPeriph(TIMER_TIM_T * timer);
void timer_enable_counter(TIMER_CONFIG_T * timerConfig);
void timer_enable_oc_channel(TIMER_CONFIG_T * timerConfig);
void timer_set_prescaler(TIMER_CONFIG_T * timerConfig);
void initTimer5(void);

#endif /*TIMER_COMMON_H_*/
