HusseinElsherbini/Self_Balancing_Robot/inc/adc.h

#ifndef ADC_H
#define ADC_H

#include "stdint.h"
#include "gpio.h"
#include "stm32f4_basetypes.h"
#include "cortex.h"
#include "dma.h"
#include "timer_common.h"
#include "platform.h"

#define NUM_OF_SENSORS    3
typedef struct
{
  __IO uint32_t SR;     /*!< ADC status register,                         Address offset: 0x00 */
  __IO uint32_t CR1;    /*!< ADC control register 1,                      Address offset: 0x04 */
  __IO uint32_t CR2;    /*!< ADC control register 2,                      Address offset: 0x08 */
  __IO uint32_t SMPR1;  /*!< ADC sample time register 1,                  Address offset: 0x0C */
  __IO uint32_t SMPR2;  /*!< ADC sample time register 2,                  Address offset: 0x10 */
  __IO uint32_t JOFR1;  /*!< ADC injected channel data offset register 1, Address offset: 0x14 */
  __IO uint32_t JOFR2;  /*!< ADC injected channel data offset register 2, Address offset: 0x18 */
  __IO uint32_t JOFR3;  /*!< ADC injected channel data offset register 3, Address offset: 0x1C */
  __IO uint32_t JOFR4;  /*!< ADC injected channel data offset register 4, Address offset: 0x20 */
  __IO uint32_t HTR;    /*!< ADC watchdog higher threshold register,      Address offset: 0x24 */
  __IO uint32_t LTR;    /*!< ADC watchdog lower threshold register,       Address offset: 0x28 */
  __IO uint32_t SQR1;   /*!< ADC regular sequence register 1,             Address offset: 0x2C */
  __IO uint32_t SQR2;   /*!< ADC regular sequence register 2,             Address offset: 0x30 */
  __IO uint32_t SQR3;   /*!< ADC regular sequence register 3,             Address offset: 0x34 */
  __IO uint32_t JSQR;   /*!< ADC injected sequence register,              Address offset: 0x38*/
  __IO uint32_t JDR1;   /*!< ADC injected data register 1,                Address offset: 0x3C */
  __IO uint32_t JDR2;   /*!< ADC injected data register 2,                Address offset: 0x40 */
  __IO uint32_t JDR3;   /*!< ADC injected data register 3,                Address offset: 0x44 */
  __IO uint32_t JDR4;   /*!< ADC injected data register 4,                Address offset: 0x48 */
  __IO uint32_t DR;     /*!< ADC regular data register,                   Address offset: 0x4C */
} ADC_TypeDef;
  
typedef struct
{
  __IO uint32_t CSR;    /*!< ADC Common status register,                  Address offset: ADC1 base address + 0x300 */
  __IO uint32_t CCR;    /*!< ADC common control register,                 Address offset: ADC1 base address + 0x304 */
  __IO uint32_t CDR;    /*!< ADC common regular data register for dual
                             AND triple modes,                            Address offset: ADC1 base address + 0x308 */
} ADC_Common_TypeDef;
// Structure for individual ADC channel configuration
typedef struct {
    GPIO_CONFIG_t gpio;          // GPIO configuration for this ADC pin
    uint8_t channel;            // ADC channel number
    uint8_t sampling_time;      // Sampling time for this channel
    uint8_t rank;              // Conversion rank in sequence
} ADC_CHANNEL_CONFIG_t;

// Structure to hold conversion results
typedef struct {
    uint16_t raw_value;        // Raw ADC value
    float voltage;             // Converted voltage value
    float scaled_value;        // Final scaled value (current, etc)
} ADC_RESULT_t;

// Structure for ADC sequence configuration
typedef struct {
    ADC_TypeDef *Instance;      // ADC peripheral instance (ADC1, ADC2, etc)
    uint8_t resolution;         // ADC resolution (12-bit, 10-bit, 8-bit)
    uint8_t align;             // Data alignment (right or left)
    uint8_t ext_trigger;       // External trigger selection
    uint8_t trigger_edge;      // Trigger detection (rising, falling, both)
    uint8_t continuous;        // Continuous conversion mode
    uint8_t dma_mode;         // DMA mode enable/disable
    uint8_t num_channels;     // Number of channels in sequence
    TIM_REGS_T *timer;        // Timer for triggering ADC
    ADC_CHANNEL_CONFIG_t *channels;  // Pointer to array of channel configs
} ADC_CONFIG_t;

typedef struct {
    ADC_CONFIG_t *port_config;
    ADC_RESULT_t channel_raw_data[NUM_OF_SENSORS];
    DMA_HandleTypeDef *dma_channel; 
} ADC_PORT_t;

extern ADC_PORT_t system_sensors;
extern ADC_CONFIG_t adc_port_config;
// Constants for configuration
typedef enum {
    ADC_RESOLUTION_12B = 0,
    ADC_RESOLUTION_10B = 1,
    ADC_RESOLUTION_8B = 2,
    ADC_RESOLUTION_6B = 3
} ADC_RESOLUTION_t;

typedef enum {
    ADC_ALIGN_RIGHT = 0,
    ADC_ALIGN_LEFT = 1
} ADC_ALIGN_t;

typedef enum {
    ADC_SAMPLETIME_3CYCLES = 0,
    ADC_SAMPLETIME_15CYCLES = 1,
    ADC_SAMPLETIME_28CYCLES = 2,
    ADC_SAMPLETIME_56CYCLES = 3,
    ADC_SAMPLETIME_84CYCLES = 4,
    ADC_SAMPLETIME_112CYCLES = 5,
    ADC_SAMPLETIME_144CYCLES = 6,
    ADC_SAMPLETIME_480CYCLES = 7
} ADC_SAMPLETIME_t;

 /* Used when we want timer or external pin to start conversion */
#define ADC_TRIGGER_NONE           0x00000000U
#define ADC_TRIGGER_T1_CC1         0x00000001U
#define ADC_TRIGGER_T1_CC2         0x00000002U
#define ADC_TRIGGER_T1_CC3         0x00000003U

/*******************  Bit definition for ADC_CR1 register  ********************/
#define ADC_CR1_AWDCH_Pos         (0U)                                         
#define ADC_CR1_AWDCH_Msk         (0x1FUL << ADC_CR1_AWDCH_Pos)                 /*!< 0x0000001F */
#define ADC_CR1_AWDCH             ADC_CR1_AWDCH_Msk                            /*!<AWDCH[4:0] bits (Analog watchdog channel select bits) */
#define ADC_CR1_AWDCH_0           (0x01UL << ADC_CR1_AWDCH_Pos)                 /*!< 0x00000001 */
#define ADC_CR1_AWDCH_1           (0x02UL << ADC_CR1_AWDCH_Pos)                 /*!< 0x00000002 */
#define ADC_CR1_AWDCH_2           (0x04UL << ADC_CR1_AWDCH_Pos)                 /*!< 0x00000004 */
#define ADC_CR1_AWDCH_3           (0x08UL << ADC_CR1_AWDCH_Pos)                 /*!< 0x00000008 */
#define ADC_CR1_AWDCH_4           (0x10UL << ADC_CR1_AWDCH_Pos)                 /*!< 0x00000010 */
#define ADC_CR1_EOCIE_Pos         (5U)                                         
#define ADC_CR1_EOCIE_Msk         (0x1UL << ADC_CR1_EOCIE_Pos)                  /*!< 0x00000020 */
#define ADC_CR1_EOCIE             ADC_CR1_EOCIE_Msk                            /*!<Interrupt enable for EOC */
#define ADC_CR1_AWDIE_Pos         (6U)                                         
#define ADC_CR1_AWDIE_Msk         (0x1UL << ADC_CR1_AWDIE_Pos)                  /*!< 0x00000040 */
#define ADC_CR1_AWDIE             ADC_CR1_AWDIE_Msk                            /*!<AAnalog Watchdog interrupt enable */
#define ADC_CR1_JEOCIE_Pos        (7U)                                         
#define ADC_CR1_JEOCIE_Msk        (0x1UL << ADC_CR1_JEOCIE_Pos)                 /*!< 0x00000080 */
#define ADC_CR1_JEOCIE            ADC_CR1_JEOCIE_Msk                           /*!<Interrupt enable for injected channels */
#define ADC_CR1_SCAN_Pos          (8U)                                         
#define ADC_CR1_SCAN_Msk          (0x1UL << ADC_CR1_SCAN_Pos)                   /*!< 0x00000100 */
#define ADC_CR1_SCAN              ADC_CR1_SCAN_Msk                             /*!<Scan mode */
#define ADC_CR1_AWDSGL_Pos        (9U)                                         
#define ADC_CR1_AWDSGL_Msk        (0x1UL << ADC_CR1_AWDSGL_Pos)                 /*!< 0x00000200 */
#define ADC_CR1_AWDSGL            ADC_CR1_AWDSGL_Msk                           /*!<Enable the watchdog on a single channel in scan mode */
#define ADC_CR1_JAUTO_Pos         (10U)                                        
#define ADC_CR1_JAUTO_Msk         (0x1UL << ADC_CR1_JAUTO_Pos)                  /*!< 0x00000400 */
#define ADC_CR1_JAUTO             ADC_CR1_JAUTO_Msk                            /*!<Automatic injected group conversion */
#define ADC_CR1_DISCEN_Pos        (11U)                                        
#define ADC_CR1_DISCEN_Msk        (0x1UL << ADC_CR1_DISCEN_Pos)                 /*!< 0x00000800 */
#define ADC_CR1_DISCEN            ADC_CR1_DISCEN_Msk                           /*!<Discontinuous mode on regular channels */
#define ADC_CR1_JDISCEN_Pos       (12U)                                        
#define ADC_CR1_JDISCEN_Msk       (0x1UL << ADC_CR1_JDISCEN_Pos)                /*!< 0x00001000 */
#define ADC_CR1_JDISCEN           ADC_CR1_JDISCEN_Msk                          /*!<Discontinuous mode on injected channels */
#define ADC_CR1_DISCNUM_Pos       (13U)                                        
#define ADC_CR1_DISCNUM_Msk       (0x7UL << ADC_CR1_DISCNUM_Pos)                /*!< 0x0000E000 */
#define ADC_CR1_DISCNUM           ADC_CR1_DISCNUM_Msk                          /*!<DISCNUM[2:0] bits (Discontinuous mode channel count) */
#define ADC_CR1_DISCNUM_0         (0x1UL << ADC_CR1_DISCNUM_Pos)                /*!< 0x00002000 */
#define ADC_CR1_DISCNUM_1         (0x2UL << ADC_CR1_DISCNUM_Pos)                /*!< 0x00004000 */
#define ADC_CR1_DISCNUM_2         (0x4UL << ADC_CR1_DISCNUM_Pos)                /*!< 0x00008000 */
#define ADC_CR1_JAWDEN_Pos        (22U)                                        
#define ADC_CR1_JAWDEN_Msk        (0x1UL << ADC_CR1_JAWDEN_Pos)                 /*!< 0x00400000 */
#define ADC_CR1_JAWDEN            ADC_CR1_JAWDEN_Msk                           /*!<Analog watchdog enable on injected channels */
#define ADC_CR1_AWDEN_Pos         (23U)                                        
#define ADC_CR1_AWDEN_Msk         (0x1UL << ADC_CR1_AWDEN_Pos)                  /*!< 0x00800000 */
#define ADC_CR1_AWDEN             ADC_CR1_AWDEN_Msk                            /*!<Analog watchdog enable on regular channels */
#define ADC_CR1_RES_Pos           (24U)                                        
#define ADC_CR1_RES_Msk           (0x3UL << ADC_CR1_RES_Pos)                    /*!< 0x03000000 */
#define ADC_CR1_RES               ADC_CR1_RES_Msk                              /*!<RES[2:0] bits (Resolution) */
#define ADC_CR1_RES_0             (0x1UL << ADC_CR1_RES_Pos)                    /*!< 0x01000000 */
#define ADC_CR1_RES_1             (0x2UL << ADC_CR1_RES_Pos)                    /*!< 0x02000000 */
#define ADC_CR1_OVRIE_Pos         (26U)                                        
#define ADC_CR1_OVRIE_Msk         (0x1UL << ADC_CR1_OVRIE_Pos)                  /*!< 0x04000000 */
#define ADC_CR1_OVRIE             ADC_CR1_OVRIE_Msk                            /*!<overrun interrupt enable */

  
/*******************  Bit definition for ADC_CR2 register  ********************/
#define ADC_CR2_ADON_Pos          (0U)                                         
#define ADC_CR2_ADON_Msk          (0x1UL << ADC_CR2_ADON_Pos)                   /*!< 0x00000001 */
#define ADC_CR2_ADON              ADC_CR2_ADON_Msk                             /*!<A/D Converter ON / OFF */
#define ADC_CR2_CONT_Pos          (1U)                                         
#define ADC_CR2_CONT_Msk          (0x1UL << ADC_CR2_CONT_Pos)                   /*!< 0x00000002 */
#define ADC_CR2_CONT              ADC_CR2_CONT_Msk                             /*!<Continuous Conversion */
#define ADC_CR2_DMA_Pos           (8U)                                         
#define ADC_CR2_DMA_Msk           (0x1UL << ADC_CR2_DMA_Pos)                    /*!< 0x00000100 */
#define ADC_CR2_DMA               ADC_CR2_DMA_Msk                              /*!<Direct Memory access mode */
#define ADC_CR2_DDS_Pos           (9U)                                         
#define ADC_CR2_DDS_Msk           (0x1UL << ADC_CR2_DDS_Pos)                    /*!< 0x00000200 */
#define ADC_CR2_DDS               ADC_CR2_DDS_Msk                              /*!<DMA disable selection (Single ADC) */
#define ADC_CR2_EOCS_Pos          (10U)                                        
#define ADC_CR2_EOCS_Msk          (0x1UL << ADC_CR2_EOCS_Pos)                   /*!< 0x00000400 */
#define ADC_CR2_EOCS              ADC_CR2_EOCS_Msk                             /*!<End of conversion selection */
#define ADC_CR2_ALIGN_Pos         (11U)                                        
#define ADC_CR2_ALIGN_Msk         (0x1UL << ADC_CR2_ALIGN_Pos)                  /*!< 0x00000800 */
#define ADC_CR2_ALIGN             ADC_CR2_ALIGN_Msk                            /*!<Data Alignment */
#define ADC_CR2_JEXTSEL_Pos       (16U)                                        
#define ADC_CR2_JEXTSEL_Msk       (0xFUL << ADC_CR2_JEXTSEL_Pos)                /*!< 0x000F0000 */
#define ADC_CR2_JEXTSEL           ADC_CR2_JEXTSEL_Msk                          /*!<JEXTSEL[3:0] bits (External event select for injected group) */
#define ADC_CR2_JEXTSEL_0         (0x1UL << ADC_CR2_JEXTSEL_Pos)                /*!< 0x00010000 */
#define ADC_CR2_JEXTSEL_1         (0x2UL << ADC_CR2_JEXTSEL_Pos)                /*!< 0x00020000 */
#define ADC_CR2_JEXTSEL_2         (0x4UL << ADC_CR2_JEXTSEL_Pos)                /*!< 0x00040000 */
#define ADC_CR2_JEXTSEL_3         (0x8UL << ADC_CR2_JEXTSEL_Pos)                /*!< 0x00080000 */
#define ADC_CR2_JEXTEN_Pos        (20U)                                        
#define ADC_CR2_JEXTEN_Msk        (0x3UL << ADC_CR2_JEXTEN_Pos)                 /*!< 0x00300000 */
#define ADC_CR2_JEXTEN            ADC_CR2_JEXTEN_Msk                           /*!<JEXTEN[1:0] bits (External Trigger Conversion mode for injected channelsp) */
#define ADC_CR2_JEXTEN_0          (0x1UL << ADC_CR2_JEXTEN_Pos)                 /*!< 0x00100000 */
#define ADC_CR2_JEXTEN_1          (0x2UL << ADC_CR2_JEXTEN_Pos)                 /*!< 0x00200000 */
#define ADC_CR2_JSWSTART_Pos      (22U)                                        
#define ADC_CR2_JSWSTART_Msk      (0x1UL << ADC_CR2_JSWSTART_Pos)               /*!< 0x00400000 */
#define ADC_CR2_JSWSTART          ADC_CR2_JSWSTART_Msk                         /*!<Start Conversion of injected channels */
#define ADC_CR2_EXTSEL_Pos        (24U)                                        
#define ADC_CR2_EXTSEL_Msk        (0xFUL << ADC_CR2_EXTSEL_Pos)                 /*!< 0x0F000000 */
#define ADC_CR2_EXTSEL            ADC_CR2_EXTSEL_Msk                           /*!<EXTSEL[3:0] bits (External Event Select for regular group) */
#define ADC_CR2_EXTSEL_0          (0x1UL << ADC_CR2_EXTSEL_Pos)                 /*!< 0x01000000 */
#define ADC_CR2_EXTSEL_1          (0x2UL << ADC_CR2_EXTSEL_Pos)                 /*!< 0x02000000 */
#define ADC_CR2_EXTSEL_2          (0x4UL << ADC_CR2_EXTSEL_Pos)                 /*!< 0x04000000 */
#define ADC_CR2_EXTSEL_3          (0x8UL << ADC_CR2_EXTSEL_Pos)                 /*!< 0x08000000 */
#define ADC_CR2_EXTEN_Pos         (28U)                                        
#define ADC_CR2_EXTEN_Msk         (0x3UL << ADC_CR2_EXTEN_Pos)                  /*!< 0x30000000 */
#define ADC_CR2_EXTEN             ADC_CR2_EXTEN_Msk                            /*!<EXTEN[1:0] bits (External Trigger Conversion mode for regular channelsp) */
#define ADC_CR2_EXTEN_0           (0x1UL << ADC_CR2_EXTEN_Pos)                  /*!< 0x10000000 */
#define ADC_CR2_EXTEN_1           (0x2UL << ADC_CR2_EXTEN_Pos)                  /*!< 0x20000000 */
#define ADC_CR2_SWSTART_Pos       (30U)                                        
#define ADC_CR2_SWSTART_Msk       (0x1UL << ADC_CR2_SWSTART_Pos)                /*!< 0x40000000 */
#define ADC_CR2_SWSTART           ADC_CR2_SWSTART_Msk                          /*!<Start Conversion of regular channels */

/*******************  Bit definition for ADC_SQR1 register  *******************/
#define ADC_SQR1_SQ13_Pos         (0U)                                         
#define ADC_SQR1_SQ13_Msk         (0x1FUL << ADC_SQR1_SQ13_Pos)                 /*!< 0x0000001F */
#define ADC_SQR1_SQ13             ADC_SQR1_SQ13_Msk                            /*!<SQ13[4:0] bits (13th conversion in regular sequence) */
#define ADC_SQR1_SQ13_0           (0x01UL << ADC_SQR1_SQ13_Pos)                 /*!< 0x00000001 */
#define ADC_SQR1_SQ13_1           (0x02UL << ADC_SQR1_SQ13_Pos)                 /*!< 0x00000002 */
#define ADC_SQR1_SQ13_2           (0x04UL << ADC_SQR1_SQ13_Pos)                 /*!< 0x00000004 */
#define ADC_SQR1_SQ13_3           (0x08UL << ADC_SQR1_SQ13_Pos)                 /*!< 0x00000008 */
#define ADC_SQR1_SQ13_4           (0x10UL << ADC_SQR1_SQ13_Pos)                 /*!< 0x00000010 */
#define ADC_SQR1_SQ14_Pos         (5U)                                         
#define ADC_SQR1_SQ14_Msk         (0x1FUL << ADC_SQR1_SQ14_Pos)                 /*!< 0x000003E0 */
#define ADC_SQR1_SQ14             ADC_SQR1_SQ14_Msk                            /*!<SQ14[4:0] bits (14th conversion in regular sequence) */
#define ADC_SQR1_SQ14_0           (0x01UL << ADC_SQR1_SQ14_Pos)                 /*!< 0x00000020 */
#define ADC_SQR1_SQ14_1           (0x02UL << ADC_SQR1_SQ14_Pos)                 /*!< 0x00000040 */
#define ADC_SQR1_SQ14_2           (0x04UL << ADC_SQR1_SQ14_Pos)                 /*!< 0x00000080 */
#define ADC_SQR1_SQ14_3           (0x08UL << ADC_SQR1_SQ14_Pos)                 /*!< 0x00000100 */
#define ADC_SQR1_SQ14_4           (0x10UL << ADC_SQR1_SQ14_Pos)                 /*!< 0x00000200 */
#define ADC_SQR1_SQ15_Pos         (10U)                                        
#define ADC_SQR1_SQ15_Msk         (0x1FUL << ADC_SQR1_SQ15_Pos)                 /*!< 0x00007C00 */
#define ADC_SQR1_SQ15             ADC_SQR1_SQ15_Msk                            /*!<SQ15[4:0] bits (15th conversion in regular sequence) */
#define ADC_SQR1_SQ15_0           (0x01UL << ADC_SQR1_SQ15_Pos)                 /*!< 0x00000400 */
#define ADC_SQR1_SQ15_1           (0x02UL << ADC_SQR1_SQ15_Pos)                 /*!< 0x00000800 */
#define ADC_SQR1_SQ15_2           (0x04UL << ADC_SQR1_SQ15_Pos)                 /*!< 0x00001000 */
#define ADC_SQR1_SQ15_3           (0x08UL << ADC_SQR1_SQ15_Pos)                 /*!< 0x00002000 */
#define ADC_SQR1_SQ15_4           (0x10UL << ADC_SQR1_SQ15_Pos)                 /*!< 0x00004000 */
#define ADC_SQR1_SQ16_Pos         (15U)                                        
#define ADC_SQR1_SQ16_Msk         (0x1FUL << ADC_SQR1_SQ16_Pos)                 /*!< 0x000F8000 */
#define ADC_SQR1_SQ16             ADC_SQR1_SQ16_Msk                            /*!<SQ16[4:0] bits (16th conversion in regular sequence) */
#define ADC_SQR1_SQ16_0           (0x01UL << ADC_SQR1_SQ16_Pos)                 /*!< 0x00008000 */
#define ADC_SQR1_SQ16_1           (0x02UL << ADC_SQR1_SQ16_Pos)                 /*!< 0x00010000 */
#define ADC_SQR1_SQ16_2           (0x04UL << ADC_SQR1_SQ16_Pos)                 /*!< 0x00020000 */
#define ADC_SQR1_SQ16_3           (0x08UL << ADC_SQR1_SQ16_Pos)                 /*!< 0x00040000 */
#define ADC_SQR1_SQ16_4           (0x10UL << ADC_SQR1_SQ16_Pos)                 /*!< 0x00080000 */
#define ADC_SQR1_L_Pos            (20U)                                        
#define ADC_SQR1_L_Msk            (0xFUL << ADC_SQR1_L_Pos)                     /*!< 0x00F00000 */
#define ADC_SQR1_L                ADC_SQR1_L_Msk                               /*!<L[3:0] bits (Regular channel sequence length) */
#define ADC_SQR1_L_0              (0x1UL << ADC_SQR1_L_Pos)                     /*!< 0x00100000 */
#define ADC_SQR1_L_1              (0x2UL << ADC_SQR1_L_Pos)                     /*!< 0x00200000 */
#define ADC_SQR1_L_2              (0x4UL << ADC_SQR1_L_Pos)                     /*!< 0x00400000 */
#define ADC_SQR1_L_3              (0x8UL << ADC_SQR1_L_Pos)                     /*!< 0x00800000 */

/********************  Bit definition for ADC_SR register  ********************/
#define ADC_SR_AWD_Pos            (0U)                                         
#define ADC_SR_AWD_Msk            (0x1UL << ADC_SR_AWD_Pos)                     /*!< 0x00000001 */
#define ADC_SR_AWD                ADC_SR_AWD_Msk                               /*!<Analog watchdog flag */
#define ADC_SR_EOC_Pos            (1U)                                         
#define ADC_SR_EOC_Msk            (0x1UL << ADC_SR_EOC_Pos)                     /*!< 0x00000002 */
#define ADC_SR_EOC                ADC_SR_EOC_Msk                               /*!<End of conversion */
#define ADC_SR_JEOC_Pos           (2U)                                         
#define ADC_SR_JEOC_Msk           (0x1UL << ADC_SR_JEOC_Pos)                    /*!< 0x00000004 */
#define ADC_SR_JEOC               ADC_SR_JEOC_Msk                              /*!<Injected channel end of conversion */
#define ADC_SR_JSTRT_Pos          (3U)                                         
#define ADC_SR_JSTRT_Msk          (0x1UL << ADC_SR_JSTRT_Pos)                   /*!< 0x00000008 */
#define ADC_SR_JSTRT              ADC_SR_JSTRT_Msk                             /*!<Injected channel Start flag */
#define ADC_SR_STRT_Pos           (4U)                                         
#define ADC_SR_STRT_Msk           (0x1UL << ADC_SR_STRT_Pos)                    /*!< 0x00000010 */
#define ADC_SR_STRT               ADC_SR_STRT_Msk                              /*!<Regular channel Start flag */
#define ADC_SR_OVR_Pos            (5U)                                         
#define ADC_SR_OVR_Msk            (0x1UL << ADC_SR_OVR_Pos)                     /*!< 0x00000020 */
#define ADC_SR_OVR                ADC_SR_OVR_Msk                               /*!<Overrun flag */

#define ADC1            (ADC_TypeDef *)ADC1_BASE 
// Define our buffer to store ADC readings
#define ADC_BUFFER_SIZE 3  // One slot for each channel
extern uint16_t adc_dma_buffer[NUM_OF_SENSORS] __attribute__((aligned(4)));  // 16-bit aligned buffer


extern ADC_CHANNEL_CONFIG_t system_sensors_configs[NUM_OF_SENSORS];  
extern DMA_HandleTypeDef hdma_adc1;

void ADC_Init_With_Timer_DMA(ADC_CONFIG_t *config, TIM_REGS_T *timer);
void ADC_Init(ADC_CONFIG_t *config);
#endif /*ADC_H*/
