HusseinElsherbini/Self_Balancing_Robot/(commit log)

2020-09-13 Create de
2024-01-10 Power supply circuit
2024-01-10 I2c schematic
2024-01-11 Added Schematics for motor driver, IMU, Transceiver and MCU
