HusseinElsherbini/Self_Balancing_Robot/(notices)

Notices in the files:
inc/SEGGER/SEGGER_RTT.h:
(c) 1995 - 2021 SEGGER Microcontroller GmbH
All rights reserved.
